lasauveetgarde/conveyor-project/тензодатчик/readme

Для выполнения измерений на прототипе конвейерной линии используется тензодатчик, принцип работы которого основывается 
на соприкосновении чувствительного элемента, находящегося на тензорезисторе, с измеряемым элементом. В реальности 
тензометрический датчик представляет из себя мост из резисторов – «Мост Уинстона», нанесенных на боковой поверхнос
ти прямоугольного алюминиевого сплава. По этой причине тензодатчик имеет 4 вывода, а для преобразования величины 
полученного сопротивления, пропорциональной величине деформации измеряющего элемент, в двоичный код, применяется АЦП.
Для того, чтобы тонкопленочные резистора меняли свое сопротивление, тензометрический датчик следует располагать таким образом, 
чтобы один конец был зафиксирован, а второй был под деформацией груза. Благодаря этому, будет возникать деформация бруска,
а вследствие и тонкопленочных резисторов.
