lasauveetgarde/conveyor-project/tcs34725/readme

В качестве датчика цветы выбран датчик на основе TCS34725, подключаемый к Arduino Uno R3
по двухпроводному интерфейсу I2C. Данный датчик обладает рядом преимуществ по сравнению аналогами,
отчего имеет широкую область применения. Модуль способен распознавать до 17 миллионов оттенков цвета,
а благодаря встроенному инфракрасному фильтру – отсекает инфракрасную составляющую,
позволяя получить более точные данные.
