lasauveetgarde/conveyor-project/hc-sr505/readme

Известно, что любой объект, имеющий температуру, способен испускать инфракрасное излучение, 
которое попадает на чувствительный сенсор в дат-чике, проходя через систему линз или сегментированных зеркал. 
При движении объекта выбранный датчик будет фиксировать линзами на сенсоре инфракрасное излучение, 
передавая соответствующий сигнал в управление. Инфракрасный датчик движения HC-SR505 выполнен без корпуса, 
т.е. со-стоит из печатной платы и самого датчика, что позволяет с легкостью монти-ровать его в систему.
