lasauveetgarde/conveyor-project/3d_model/description.md

Для печати нужно 1 шкив с размерами 22_6_7, два шкива с размерами 24_8_8
