lasauveetgarde/conveyor-project/software/matlab/ПРОВЕРКА.docx

ГОЛУБОЙ 55 5,6

ОРАНЖЕВЫЙ 75 5,7

ЗЕЛЕНЫЙ 40 2,9

ЖЕЛТЫЙ 50 3,7

КРАСНЫЙ 40 3,5

СИНИЙ 45 3,7

СИНИЙ 4О 3

ФИОЛЕТОВЫЙ 35 2,6

ФИОЛЕТОВЫЙ 55 4,8

ОРАНЖЕВЫЙ 45 4,5

ЗЕЛЕНЫЙ 55 3,7

ГОЛУБОЙ 55 4,8
