lasauveetgarde/conveyor-project/hc-sr505/hc_sr505_bb.png

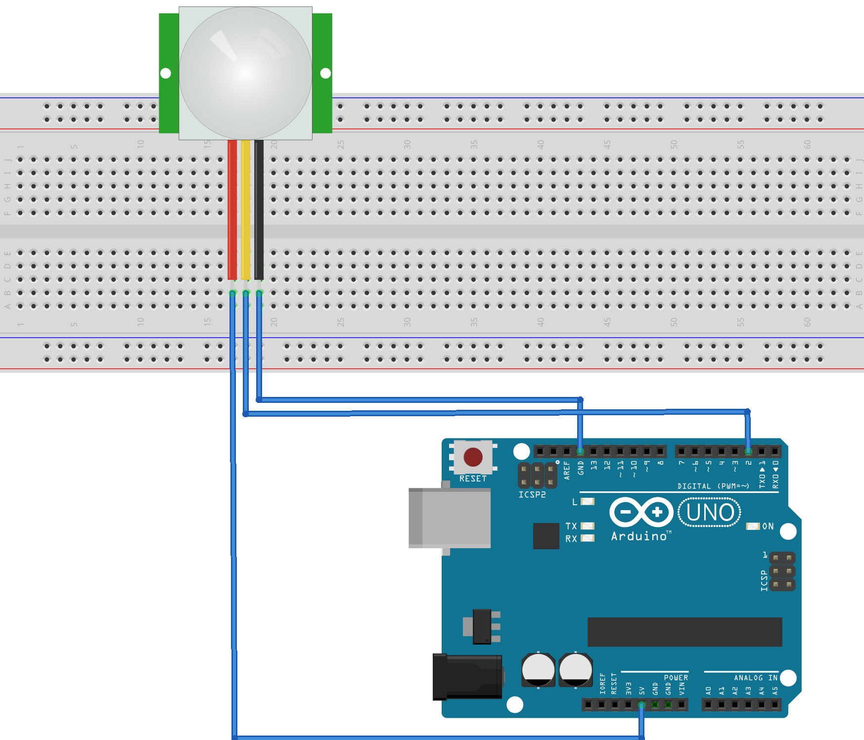
hc-sr505/hc_sr505_bb.png
