lasauveetgarde/conveyor-project/hc-sr505/hc_sr505_схема.png

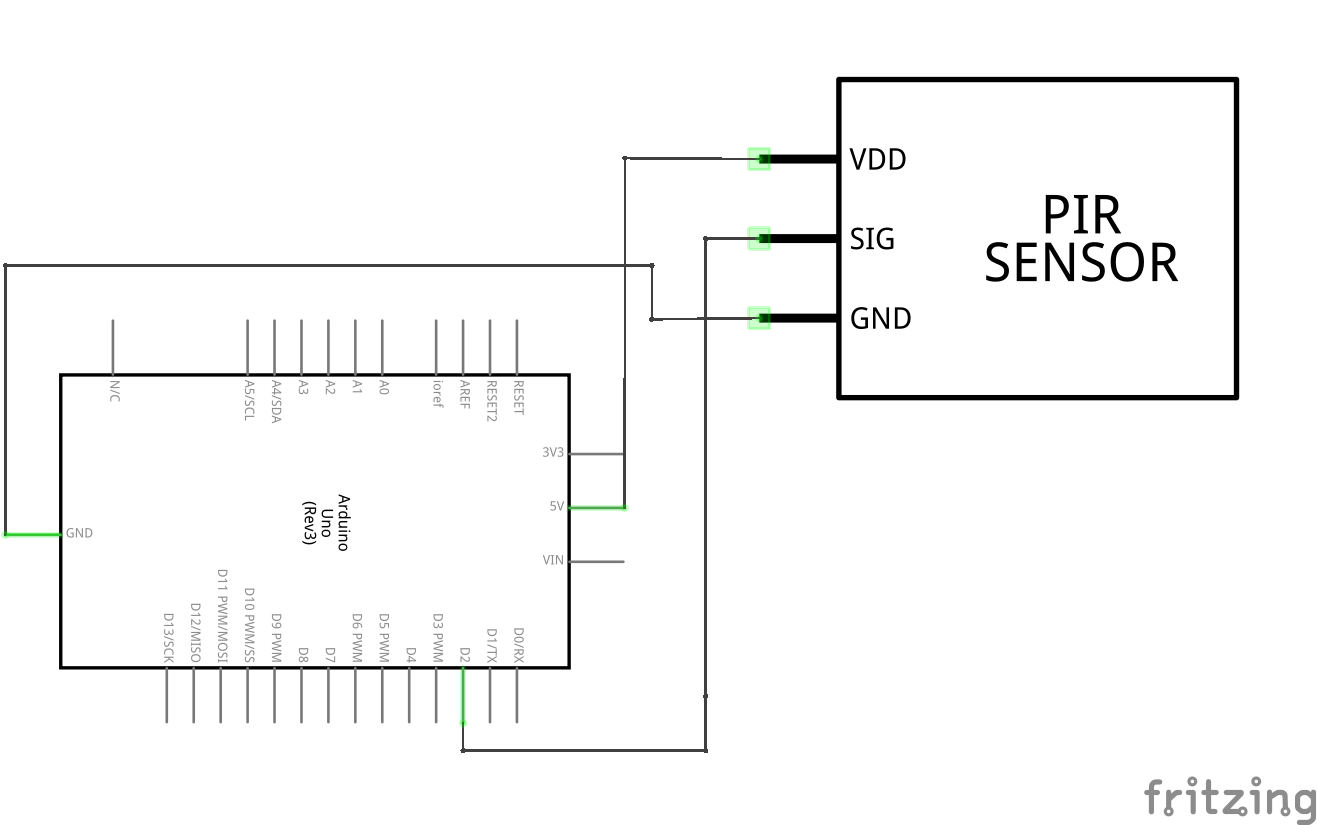
hc-sr505/hc_sr505_схема.png
