lasauveetgarde/conveyor-project/software/matlab/Piechart.png

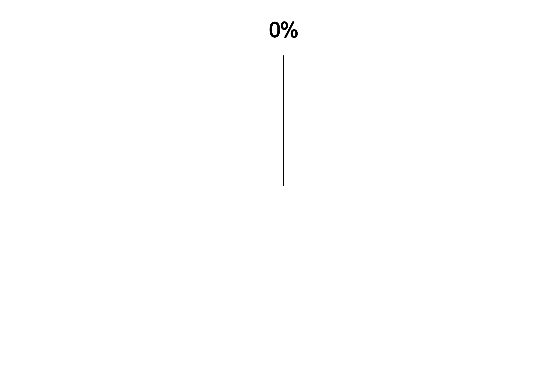
software/matlab/Piechart.png
