lasauveetgarde/conveyor-project/tcs34725/tcs34725_bb.png

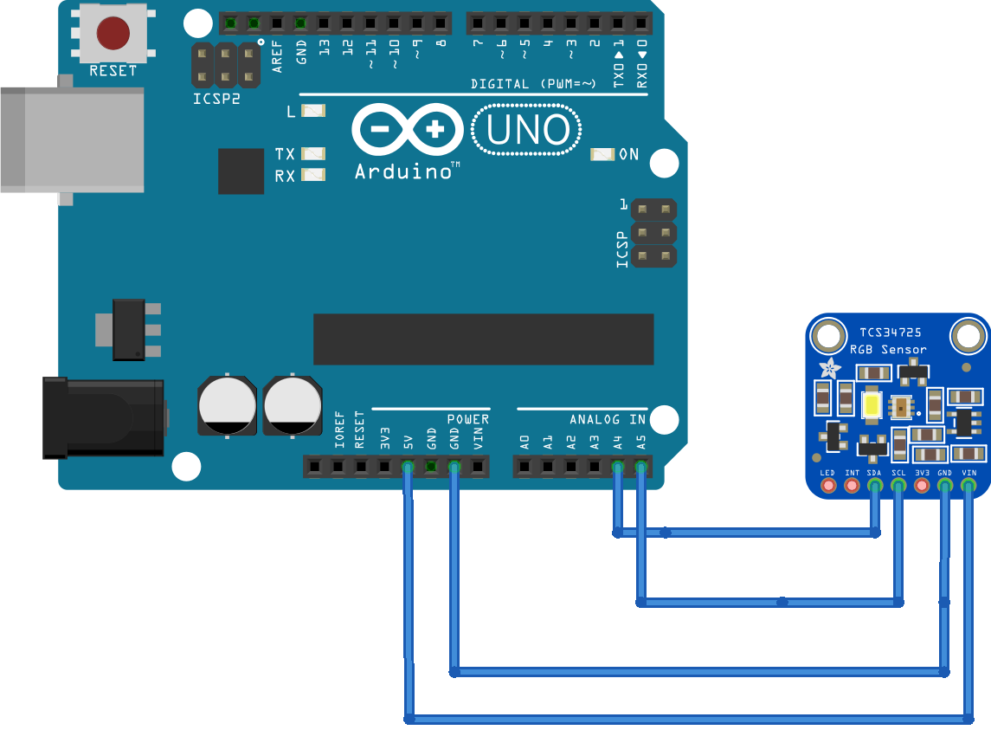
tcs34725/tcs34725_bb.png
