lasauveetgarde/conveyor-project/tcs34725/tcs34725_схема.png

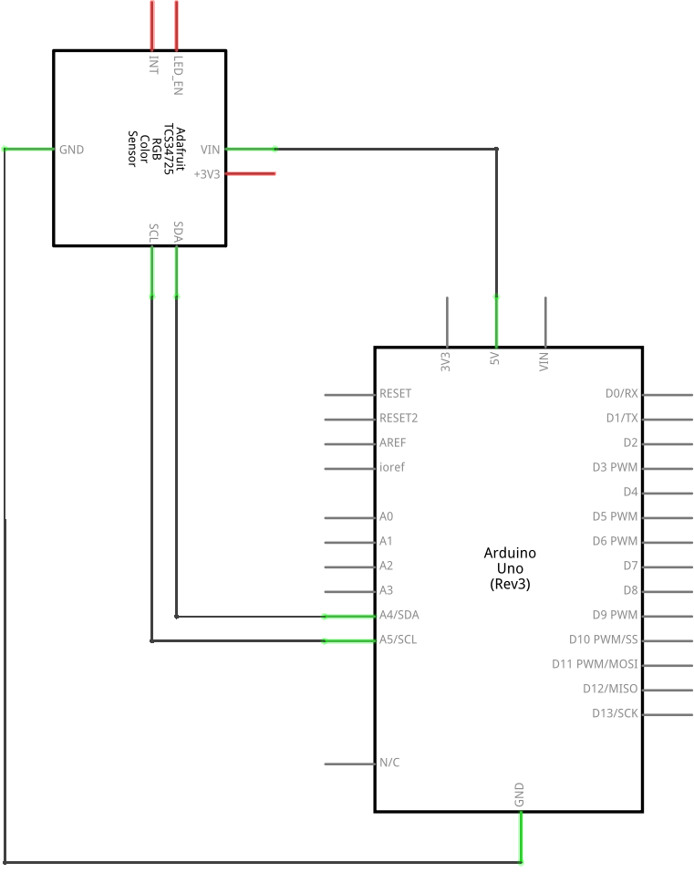
tcs34725/tcs34725_схема.png
