lasauveetgarde/conveyor-project/тензодатчик/hx711_bb.png

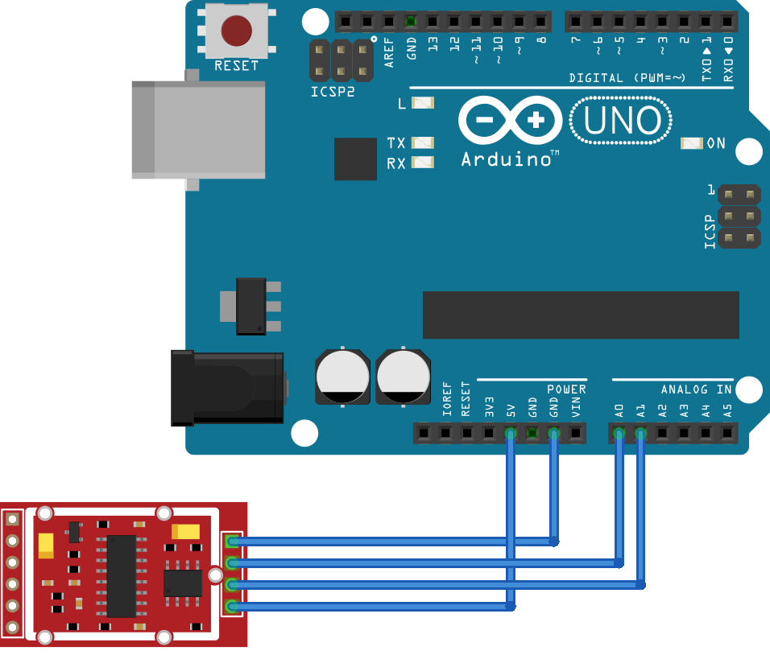
тензодатчик/hx711_bb.png
