lasauveetgarde/conveyor-project/тензодатчик/hx711_схема.png

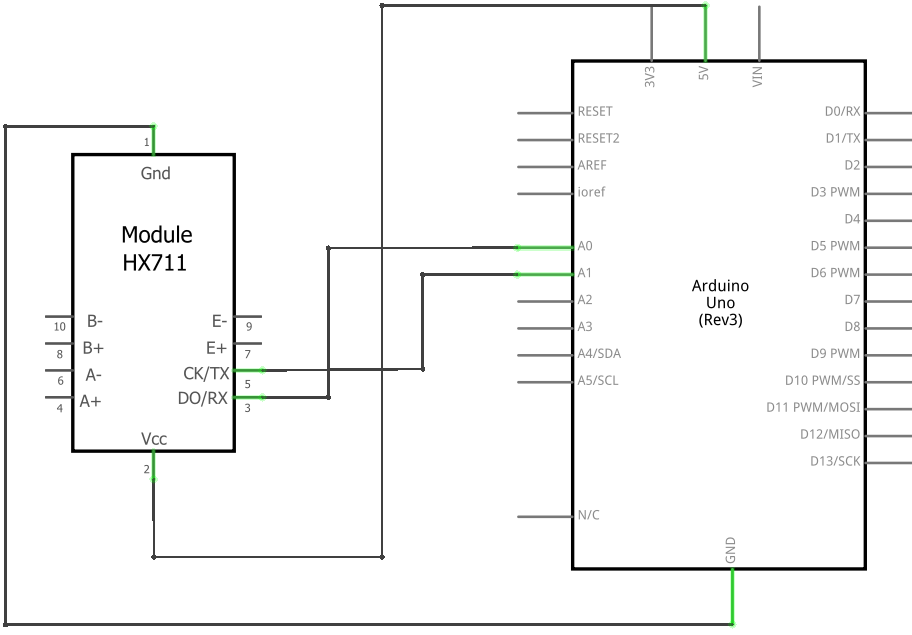
тензодатчик/hx711_схема.png
