lasauveetgarde/conveyor-project/3d_model/ColourSensor/ColourSensorNew/colour-stand_fix.stl

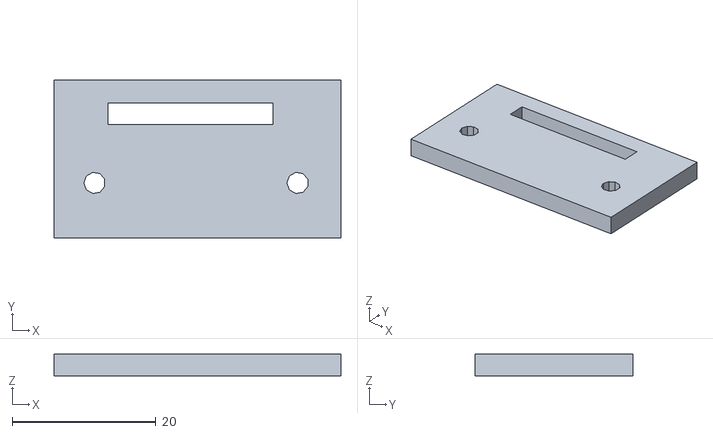
[picture p59: CAD file, 2022-02-09]
3d_model/ColourSensor/ColourSensorNew/colour-stand_fix.stl
40.0 x 22.0 x 3.00
