lasauveetgarde/conveyor-project/3d_model/ColourSensor/NEW26-04-colour-stand1.stl

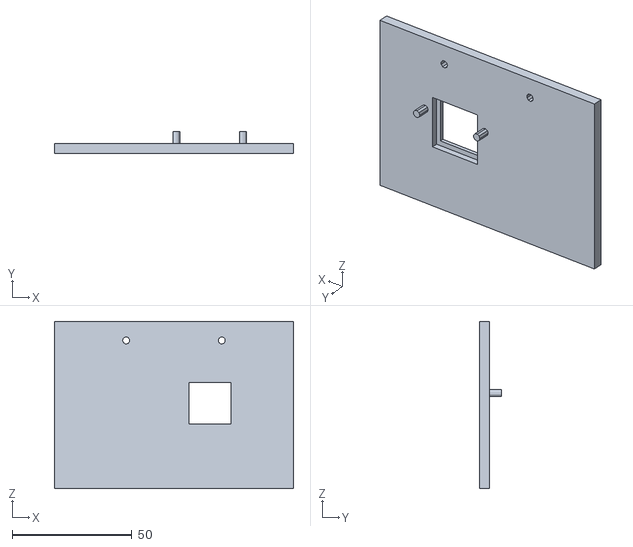
[picture p60: CAD file, 2022-05-10]
3d_model/ColourSensor/NEW26-04-colour-stand1.stl
100.0 x 9.00 x 70.0
