lasauveetgarde/conveyor-project/3d_model/load_Cell/крепежный уголок для тензы.stl

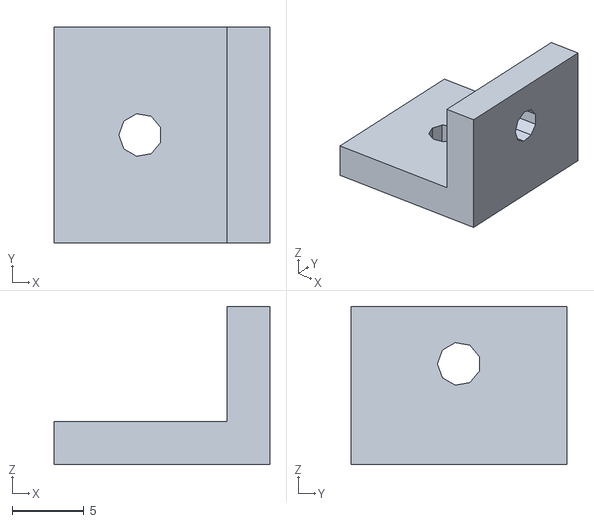
[picture p61: CAD file, 2022-01-21]
3d_model/load_Cell/крепежный уголок для тензы.stl
15.0 x 15.0 x 11.0
