lasauveetgarde/conveyor-project/3d_model/new_3d/NEW_MM_pulley_motor.stl

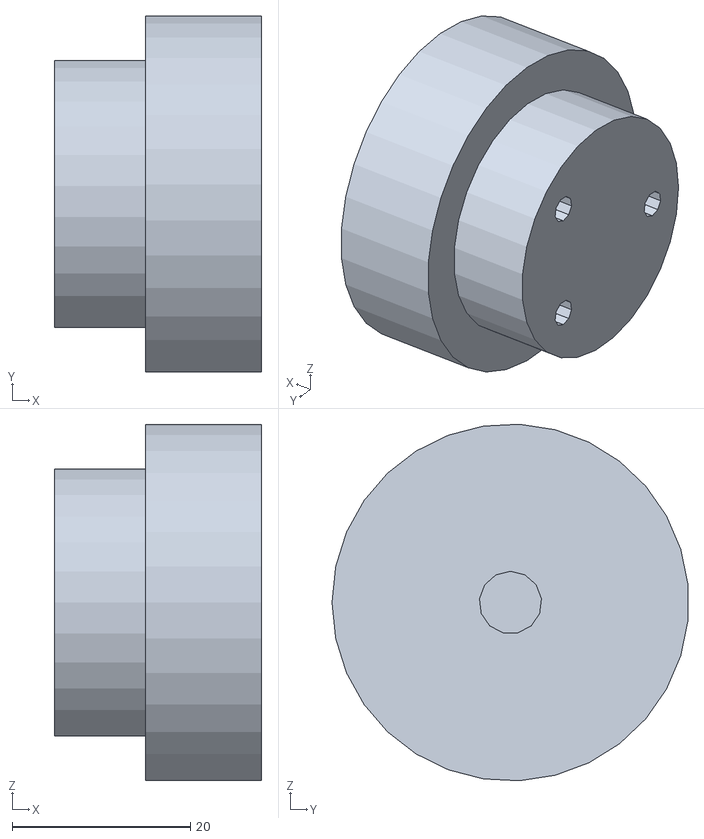
[picture p63: CAD file, 2021-11-19]
3d_model/new_3d/NEW_MM_pulley_motor.stl
23.2 x 39.9 x 39.9
