lasauveetgarde/conveyor-project/3d_model/puley_for_puley.SLDPRT

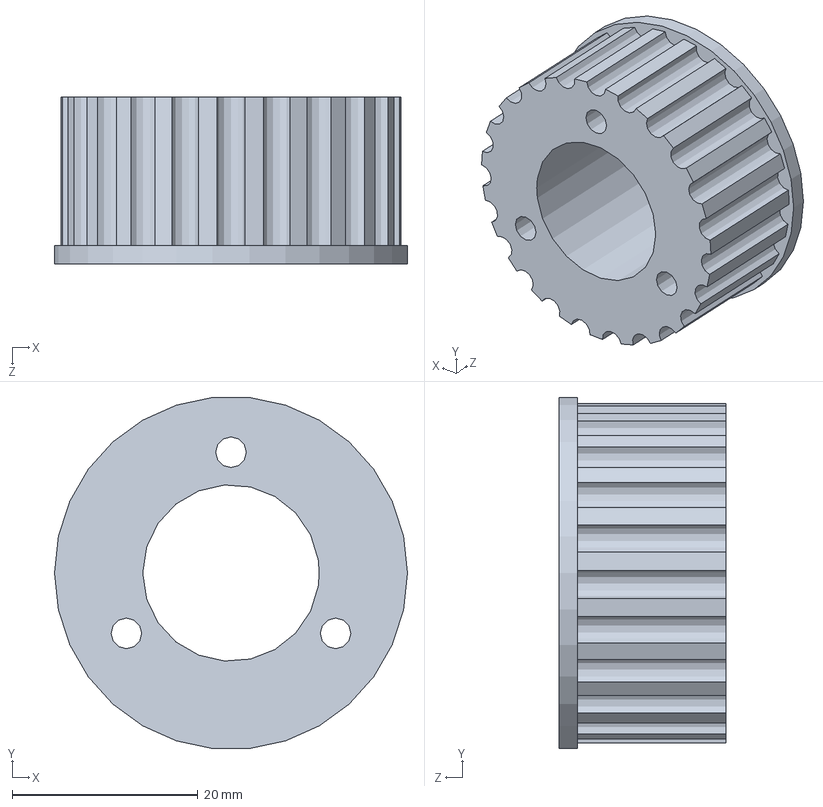
[picture p64: CAD file, 2021-11-20]
3d_model/puley_for_puley.SLDPRT
38.0 x 37.8 x 18.0 mm
