lasauveetgarde/conveyor-project/3d_model/Servo/ServoNozzle.stl

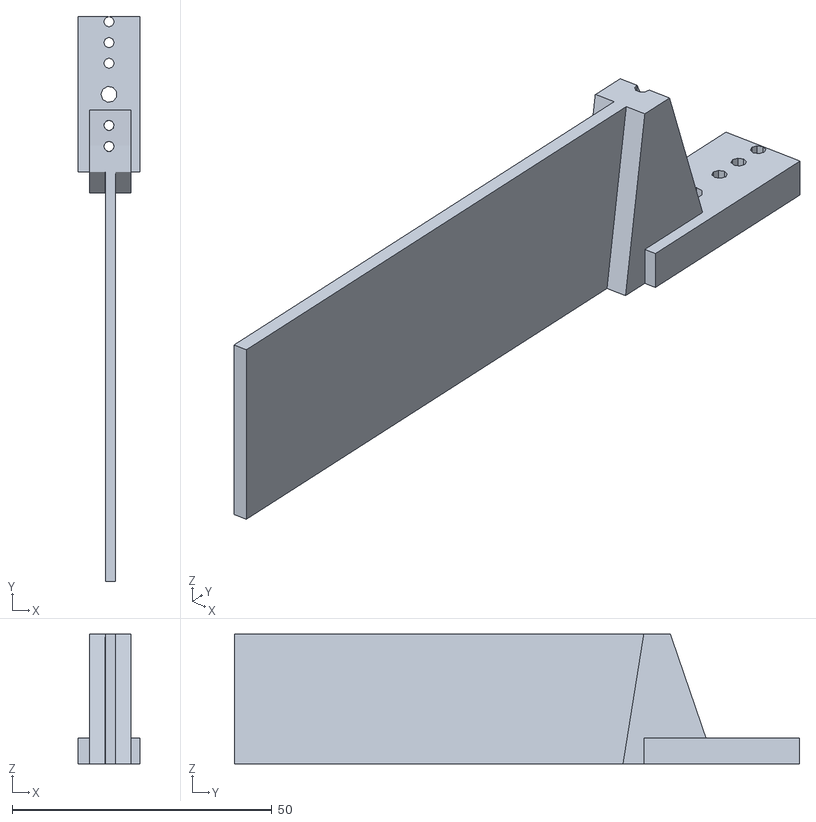
[picture p65: CAD file, 2022-05-10]
3d_model/Servo/ServoNozzle.stl
12.0 x 108.8 x 25.0
