lasauveetgarde/conveyor-project/3d_model/Ultrasonic Sensor/Ultrasonic Sensor.stl

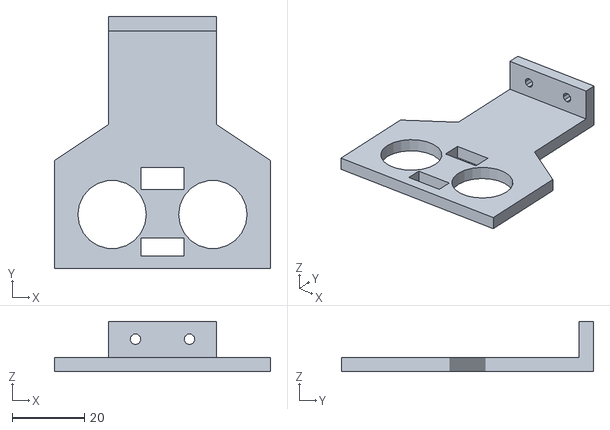
[picture p66: CAD file, 2022-04-19]
3d_model/Ultrasonic Sensor/Ultrasonic Sensor.stl
60.0 x 70.0 x 14.0
