lasauveetgarde/conveyor-project/3d_model/ColourSensor/colour-stand1.stl

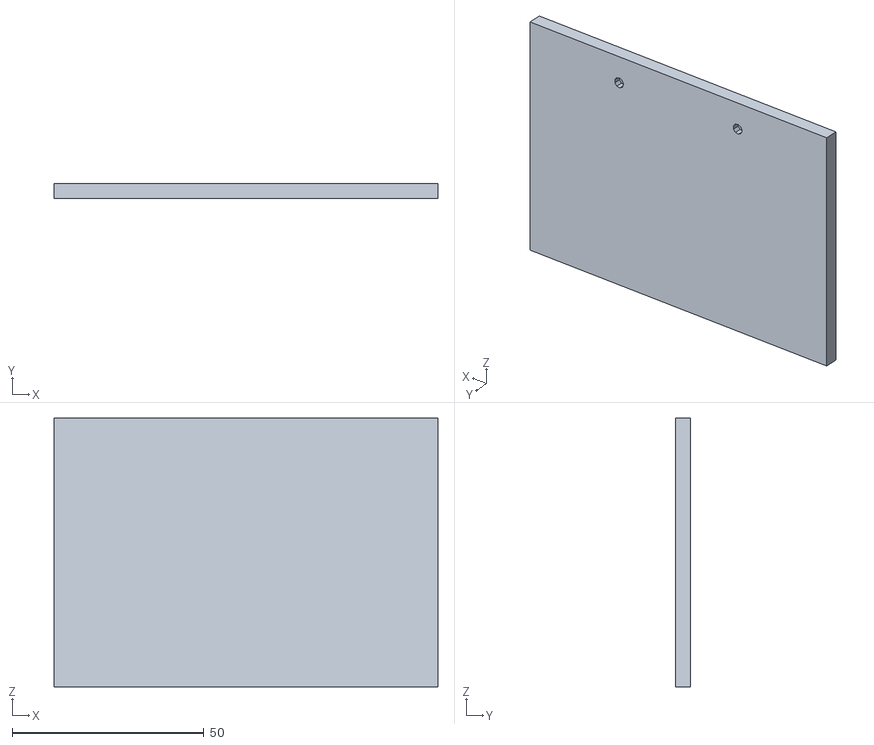
[picture p67: CAD file, 2022-01-21]
3d_model/ColourSensor/colour-stand1.stl
100.0 x 4.00 x 70.0
