lasauveetgarde/conveyor-project/3d_model/load_Cell/load_cell_stand_M4.stl

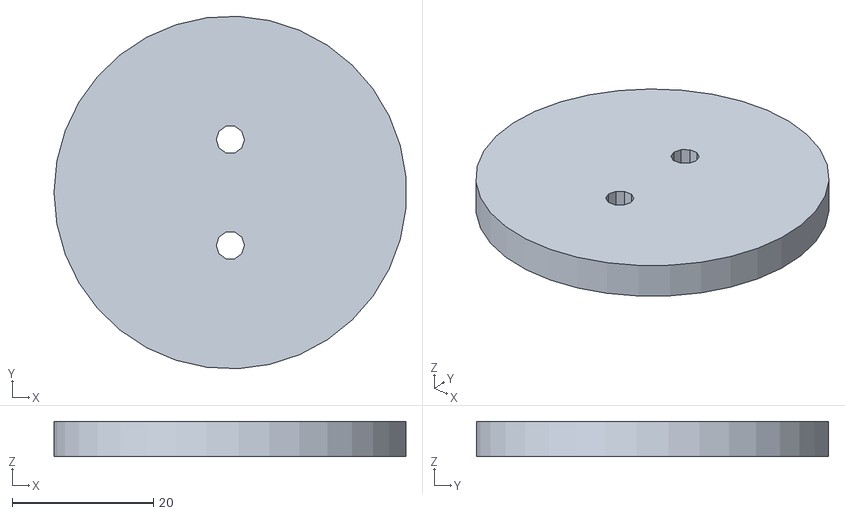
[picture p68: CAD file, 2022-01-21]
3d_model/load_Cell/load_cell_stand_M4.stl
49.9 x 49.9 x 5.00
