lasauveetgarde/conveyor-project/3d_model/MotorPulley/pulley_to_motor_part2.stl

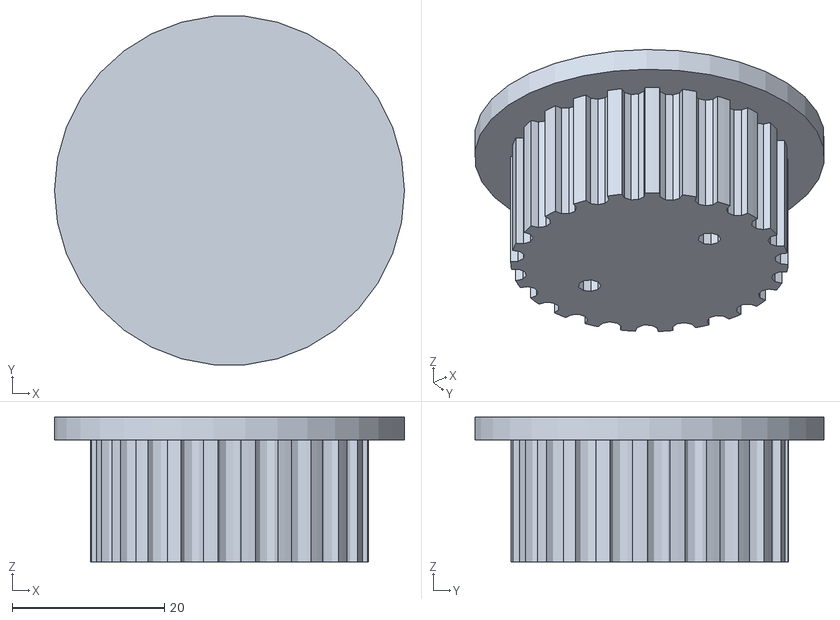
[picture p69: CAD file, 2022-04-19]
3d_model/MotorPulley/pulley_to_motor_part2.stl
46.0 x 45.8 x 19.0
