lasauveetgarde/conveyor-project/3d_model/new_3d/NEW_GV_pulley_22_6_7.stl

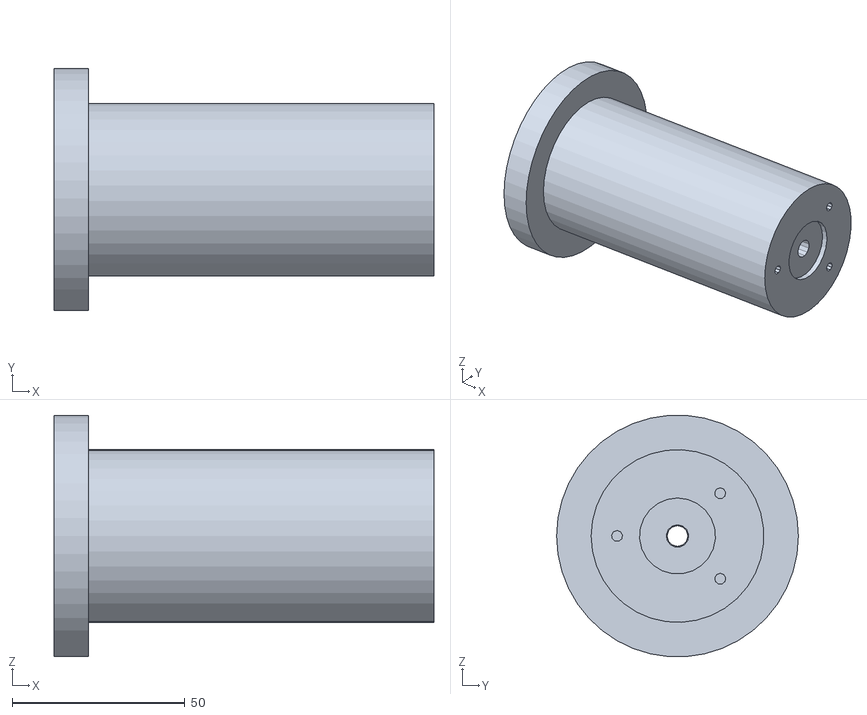
[picture p70: CAD file, 2021-11-19]
3d_model/new_3d/NEW_GV_pulley_22_6_7.stl
110.0 x 70.0 x 69.8
