lasauveetgarde/conveyor-project/3d_model/puley_for_motor.SLDPRT

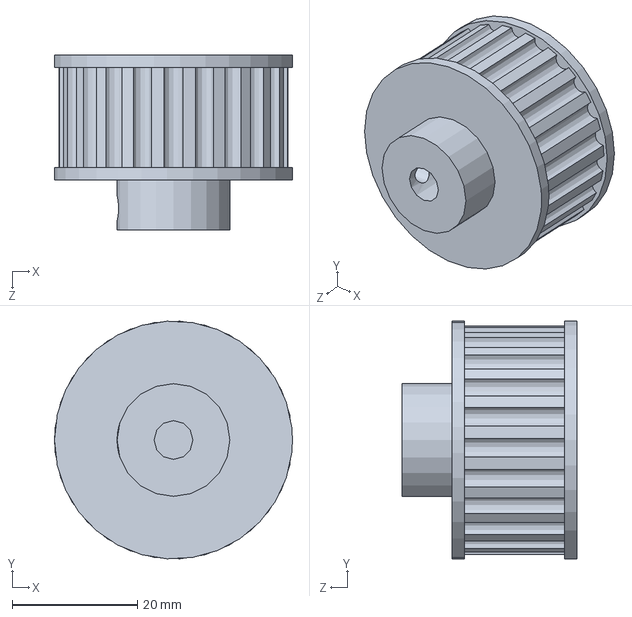
[picture p71: CAD file, 2021-11-20]
3d_model/puley_for_motor.SLDPRT
38.0 x 37.9 x 28.0 mm
