lasauveetgarde/conveyor-project/3d_model/Big_puley.SLDPRT

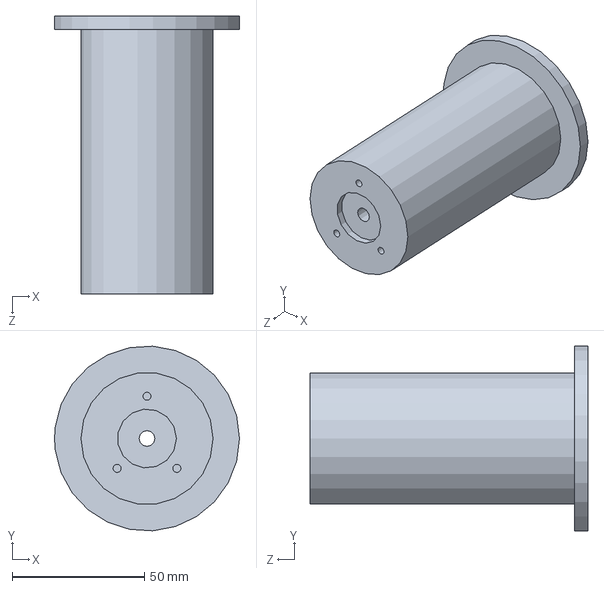
[picture p72: CAD file, 2021-11-20]
3d_model/Big_puley.SLDPRT
70.0 x 69.9 x 105.0 mm
