lasauveetgarde/conveyor-project/3d_model/ColourSensor/colour-stand2.stl

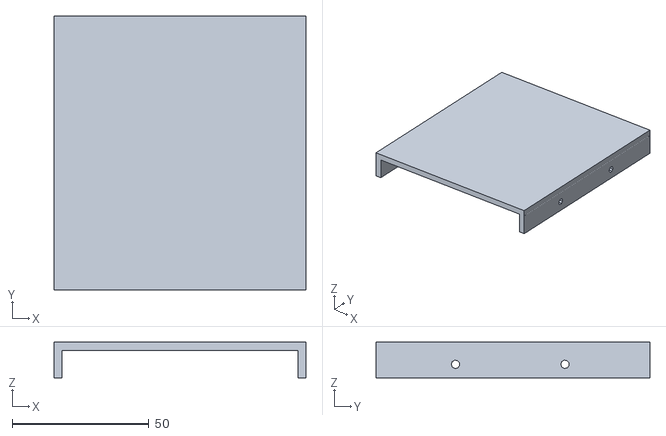
[picture p73: CAD file, 2022-01-21]
3d_model/ColourSensor/colour-stand2.stl
92.1 x 100.0 x 13.0
