lasauveetgarde/conveyor-project/3d_model/load_Cell/load_cell_stand_M5.stl

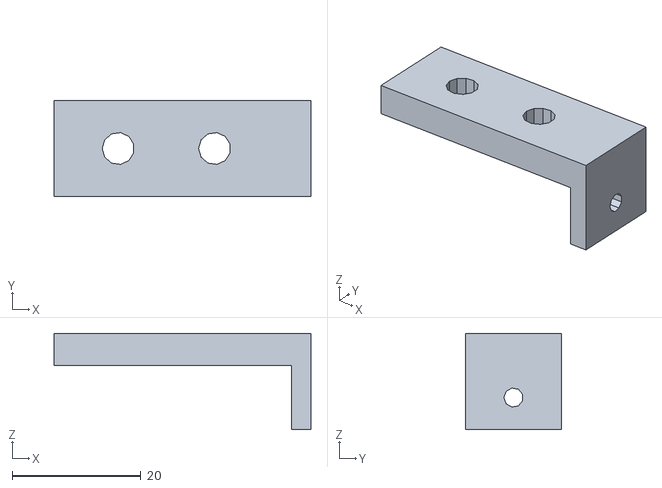
[picture p74: CAD file, 2022-01-21]
3d_model/load_Cell/load_cell_stand_M5.stl
40.0 x 15.0 x 15.0
