lasauveetgarde/conveyor-project/3d_model/new_3d/NEW_GV_side_pulley_to_22-6-7.stl

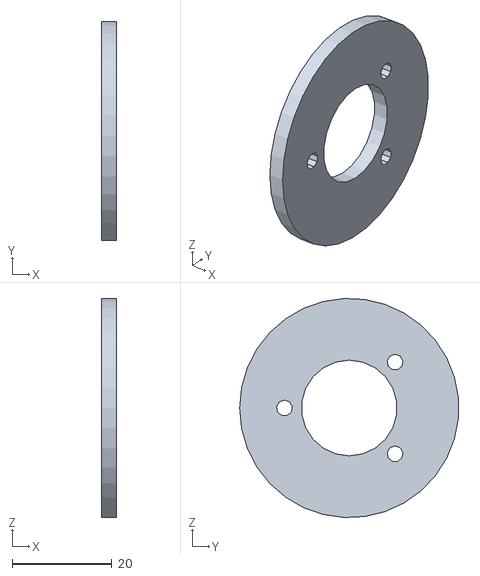
[picture p75: CAD file, 2021-11-19]
3d_model/new_3d/NEW_GV_side_pulley_to_22-6-7.stl
3.00 x 43.9 x 44.0
