lasauveetgarde/conveyor-project/3d_model/load_Cell/load_cell_stand.stl

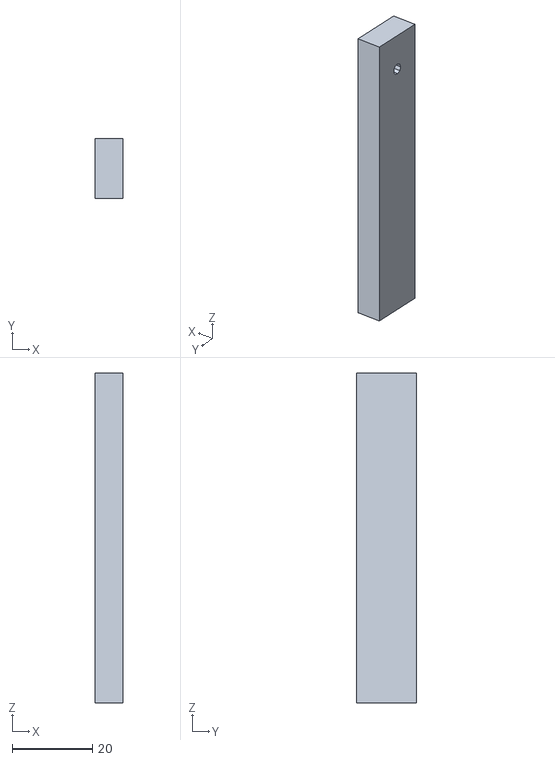
[picture p76: CAD file, 2022-01-21]
3d_model/load_Cell/load_cell_stand.stl
7.00 x 15.0 x 82.0
