lasauveetgarde/conveyor-project/3d_model/new_3d/NEW_GV_pulley_to_22-6-7.stl

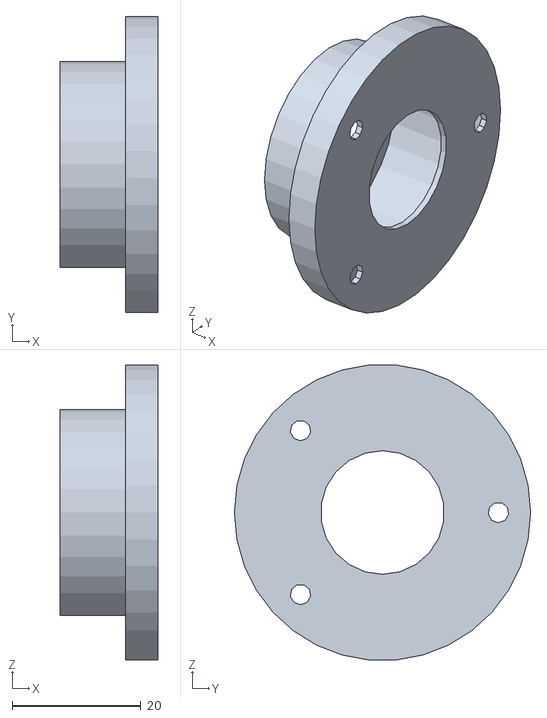
[picture p78: CAD file, 2021-11-19]
3d_model/new_3d/NEW_GV_pulley_to_22-6-7.stl
15.2 x 46.0 x 45.8
