lasauveetgarde/conveyor-project/3d_model/wall_without_motor.dxf

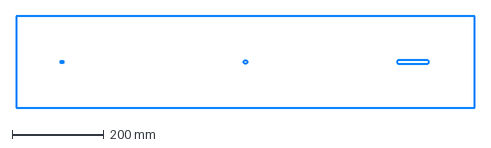
[picture p79: CAD file, 2021-10-21]
3d_model/wall_without_motor.dxf
1000.0 x 200.0 mm
