lasauveetgarde/conveyor-project/3d_model/new_3d/NEW_GV_pulley_motor_side.stl

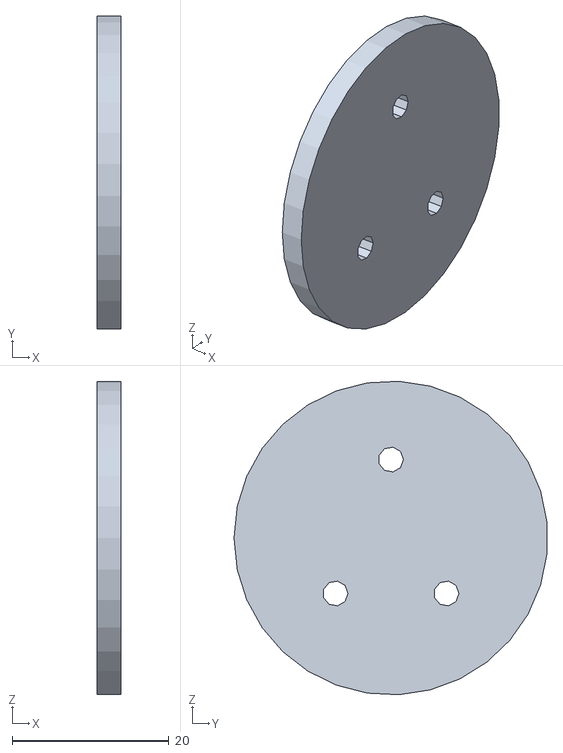
[picture p80: CAD file, 2021-11-19]
3d_model/new_3d/NEW_GV_pulley_motor_side.stl
3.00 x 39.9 x 39.9
