lasauveetgarde/conveyor-project/3d_model/pulley_24_8_8.stl

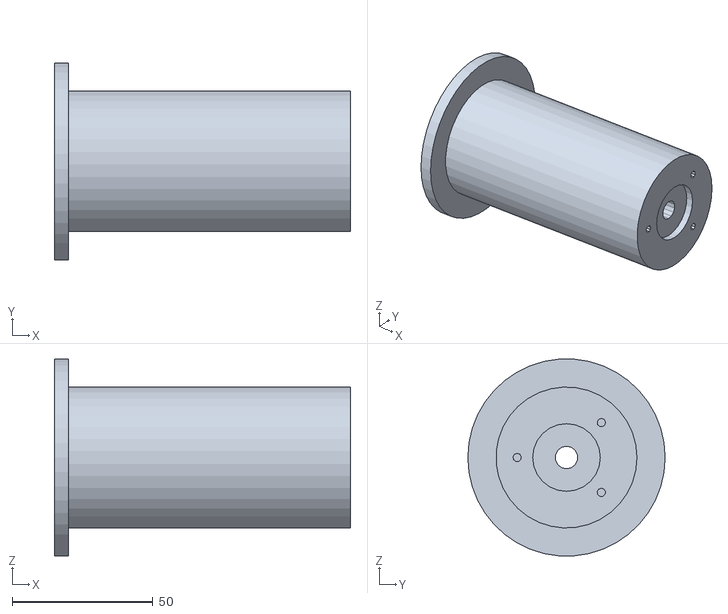
[picture p81: CAD file, 2021-10-20]
3d_model/pulley_24_8_8.stl
105.0 x 70.0 x 69.8
