lasauveetgarde/conveyor-project/3d_model/side_22_6_7.stl

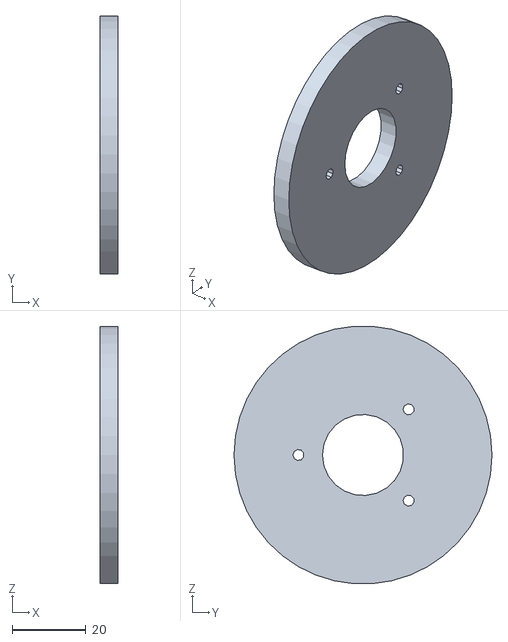
[picture p82: CAD file, 2021-10-20]
3d_model/side_22_6_7.stl
5.00 x 70.0 x 69.8
