lasauveetgarde/conveyor-project/3d_model/side_24_8_8.stl

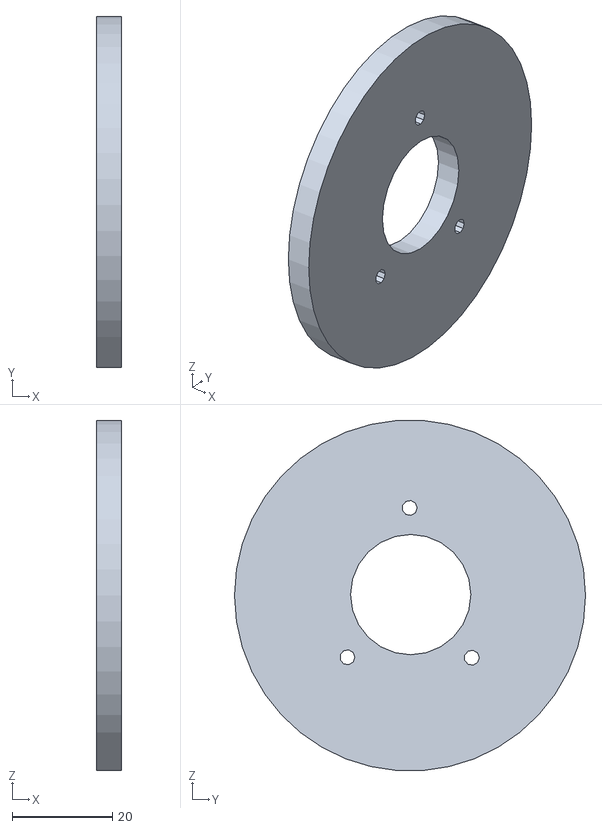
[picture p83: CAD file, 2021-10-20]
3d_model/side_24_8_8.stl
5.00 x 70.0 x 69.8
