lasauveetgarde/conveyor-project/3d_model/шкив1.stl

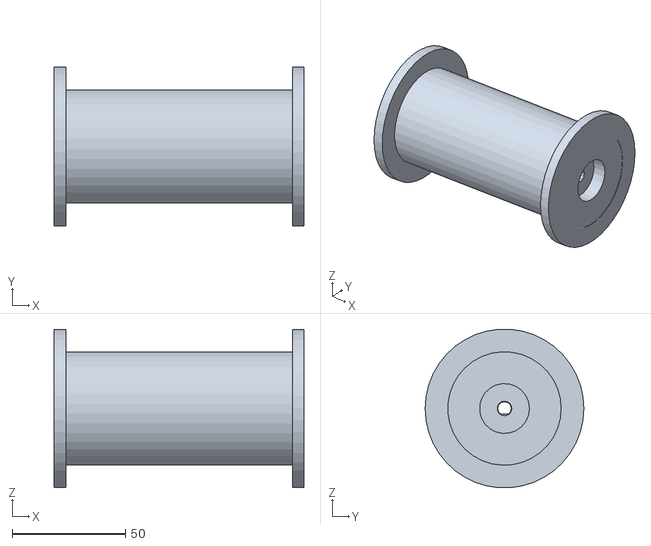
[picture p84: CAD file, 2021-10-13]
3d_model/шкив1.stl
110.2 x 70.0 x 69.8
