lasauveetgarde/conveyor-project/3d_model/шкив.stl

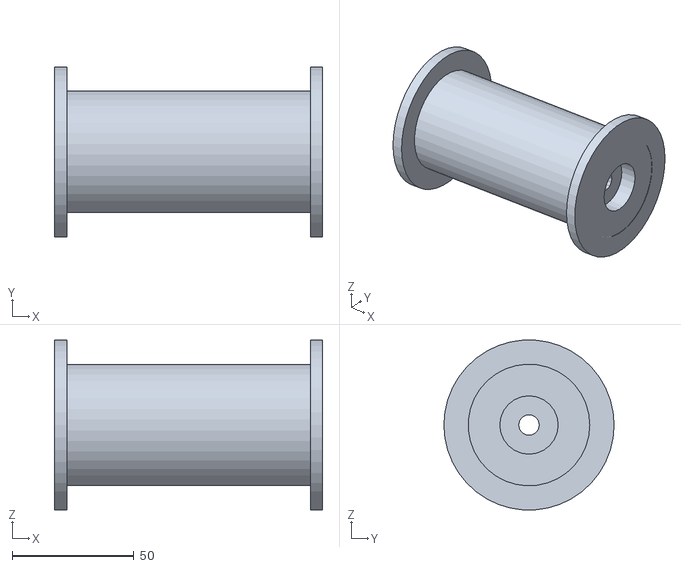
[picture p85: CAD file, 2021-09-27]
3d_model/шкив.stl
110.2 x 70.0 x 69.8
