lasauveetgarde/conveyor-project/(list of files, cad)

Other CAD files:
3d_model/ColourSensor/ColourSensorNew/colour-stand1.stl
3d_model/MotorPulley/pulley_to_motor_part1.stl
3d_model/new_3d/NEW_GV_pulley_motor.stl
3d_model/pulley_22_6_7.stl
3d_model/Big_puley.STL
3d_model/puley_for_motor.STL
3d_model/puley_for_puley.STL
