lasauveetgarde/conveyor-project/(commit log)

2021-11-20 Some puleys
    [Big_puley.SLDPRT, Big_puley.STL, puley_for_motor.SLDPRT, puley_for_motor.STL, puley_for_puley.SLDPRT, puley_for_puley.STL]
2022-03-10 troubles with servo
2022-03-10 correct servo
2022-03-14 edit knob.problem reading motorspeed
2022-03-15 add text area to view motor speed
2022-03-16 add correct color pie, correct time and xls
    [usertable.xls]
2022-03-22 need fix value queue
    [main_conveyor.ino]
2022-03-22 deleted usertable
    [usertable.xls]
2022-03-22 no problem of reading data from arduino
    [main_conveyor.ino]
2022-03-23 correct arduino reading
2022-03-23 correct sorting by color and weight,need a new power supply for the servo and deal with the length
    [main_conveyor.ino]
2022-03-24 correct servo work
2022-03-27 нихера не получилось и я расстроилась
2022-03-28 закончили
2022-04-19 added correction for the prototype
    [main_conveyor.ino]
2022-05-11 add timer stop
2022-05-17 new save
    [usertable.xlsx, КОНТРОЛЬ2.xlsx, Результаты эксперимента.xlsx, проверка работоспособности системы.xlsx]
